donfroula/wifi_beehive_lamps/beehive2_small.jpg

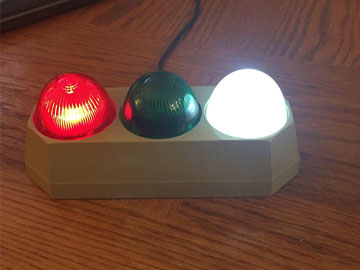
beehive2_small.jpg
