donfroula/wifi_beehive_lamps/beehive3_large.jpg

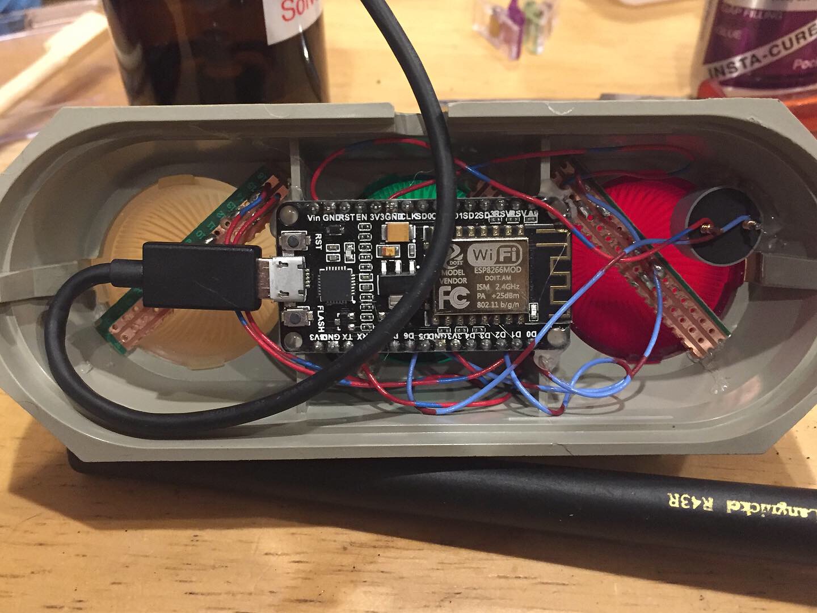
beehive3_large.jpg
