donfroula/wifi_beehive_lamps/beehive1_small.jpg

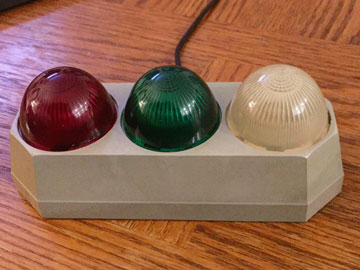
beehive1_small.jpg
