donfroula/wifi_beehive_lamps/(commit log)

2019-08-26 Update remote_beehive.ino
    Added flashing red LED until initial connection to WIFI is successful.
2019-08-31 Update README.md
    Updated to include serial monitor board rate and static IP version.
2019-08-31 Add files via upload
    Added a version that supports fixed IP addresses.
    [remote_beehive_fixed_ip.ino]
